davidmc5/Wifi_Node_PCB/BOM - WIFI RELAY NODE.xlsx

Qty | Value | Device | Package | Parts | Description | DIGI-KEY_PART_NUMBER | DIGI-KEY_PURCHASE_URL | MF | MPN | PRICE | Extended price | Comments
0 | 20V 0.5A | Diode MBR0520 | SOD123 | D1, D2 | Diode Schottky 20V 500mA | MBR0520LT3GOSCT-ND | https://www.digikey.com/product-detail/en/on-semiconductor/MBR0520LT3G/MBR0520LT3GOSCT-ND/2705022 | ON Semiconductor | MBR0520LT3G | $0.34 | $0.00
2 | 20V 0.5A | Diode MBR0520 | SOD123 | D1, D2 | Diode Schottky 20V 500mA | MBR0520LT1GOSCT-ND | https://www.digikey.com/product-detail/en/on-semiconductor/MBR0520LT3G/MBR0520LT3GOSCT-ND/2705022 | ON Semiconductor | MBR0520LT3G | $0.04 | $0.08 | For JLCPCB - Digikey had 0 stock
5 | 0.1uF | 0.1UF 25V-20% | 0603 | C5, C6, C7, C8, C9 | 0.1µF ceramic capacitors | 399-1100-1-ND | https://www.digikey.com/product-detail/en/kemet/C0603C104Z3VACTU/399-1100-1-ND/411375 | KEMET | C0603C104Z3VACTU | $0.10 | $0.50
4 | 10uF | 10UF-25V-20% | 0805 | C1, C2, C3, C4 | 10.0µF ceramic capacitors | 490-10503-1-ND | https://www.digikey.com/product-detail/en/murata-electronics/GRM21BC81E106ME51L/490-10503-1-ND/5026431 | Murata Electronics | GRM21BC81E106ME51L | $0.37 | $1.48
4 | 10k | 10KOHM-0603-1/10W-5% | 0603 | R1, R2, R3, R4 | 10k resistor | 311-10KGRCT-ND | https://www.digikey.com/product-detail/en/yageo/RC0603JR-0710KL/311-10KGRCT-ND/729647 | Yageo | RC0603JR-0710KL | $0.10 | $0.40
3 | 1k | 1KOHM-0603-1/10W-5% | 603 | R5, R6, R7 | 1k resistor | 311-1.0KGRCT-ND | https://www.digikey.com/product-detail/en/yageo/RC0603JR-071KL/311-1-0KGRCT-ND/729624 | Yageo | RC0603JR-071KL | $0.10 | $0.30
0 | 8-pin male header | CONN_1X08 | 1x08 | J4 | Header-pin |  |  |  |  |  | $0.00
1 | ESP-WROOM-02U | ESP-WROOM-02U | 18-SMD Module | U1 | WiFi module | 1904-1022-1-ND | https://www.digikey.com/product-detail/en/espressif-systems/ESP-WROOM-02U/1904-1022-1-ND/9381731 | Espressif Systems | ESP-WROOM-02U | $3.20 | $3.20
1 | 2-Pin male header | CONN_1X02 | 1X02 (Pitch 2.54mm) | J2 | 2-Pin male header | 952-2262-ND | https://www.digikey.com/product-detail/en/harwin-inc/M20-9990246/952-2262-ND/3728226 | Harwin | M20-9990246 | $0.11 | $0.11
1 | 6-Pin male header | CONN_1X06 | 1X06 (Pitch 2.54mm) | J3 | 6-Pin male header | 609-3263-ND | https://www.digikey.com/product-detail/en/amphenol-icc-fci/68000-406HLF/609-3263-ND/1878471 | Amphenol | 68000-406HLF | $0.27 | $0.27
1 | 20-pin Female header | CONN_2X10 | 2X10 (Pitch 2.54mm) | J1 | 20-pin Female header | S7078-ND | https://www.digikey.com/product-detail/en/sullins-connector-solutions/PPTC102LFBN-RC/S7078-ND/810216 | Sullins | PPTC102LFBN-RC | $1.30 | $1.30
 |  |  |  |  |  |  |  |  |  |  | $0.00
0 | TLV75533 | Voltage regulator 3.3 V - 500 mA | SOT-23-5 | U3 | Linear Voltage Regulator | 296-50411-1-ND | https://www.digikey.com/product-detail/en/texas-instruments/TLV75533PDBVR/296-50411-1-ND/9685550 | Texas Instruments | TLV75533PDBVR | $0.39 | $0.00
1 | MIC5504-3.3 | Voltage regulator 3.3 V - 300 mA | SOT-23-5 | U3 | Linear Voltage Regulator | 576-4764-1-ND | https://www.digikey.com/product-detail/en/microchip-technology/MIC5504-3-3YM5-TR/576-4764-1-ND/4864028 | Microchip Technology | MIC5504-3.3YM5-TR | $0.11 | $0.11 | For JLCPCB
 |  |  |  |  |  |  |  |  |  |  | $0.00
0 | MCP23018 | I/O expander 16bit | 24-SSOP | U2 | I/O expander 16bit | MCP23018-E/SS-ND | https://www.digikey.com/product-detail/en/microchip-technology/MCP23018-E-SS/MCP23018-E-SS-ND/1999506 | Microchip Technology | MCP23018-E/SS | $1.66 | $0.00
1 | MCP23018 | I/O expander 16bit | 28-SOIC | U2 | I/O expander 16bit | MCP23018-E/SO-ND | https://www.digikey.com/product-detail/en/microchip-technology/MCP23018-E-SO/MCP23018-E-SO-ND/1999504 | Microchip Technology | MCP23018-E/SO | $1.51 | $1.51 | Larger pitch to make it easier to solder by hand
~~0~~ | ~~MCP23018~~ | ~~MCP23018T-E/SO~~ | ~~28-SOIC~~ | ~~U2~~ | ~~I/O expander 16bit~~ | ~~MCP23018T-E/SOCT-ND~~ | ~~https://www.digikey.com/product-detail/en/microchip-technology/MCP23018T-E-SO/MCP23018T-E-SOCT-ND/9643016~~ | ~~Microchip Technology~~ | ~~MCP23018T-E/SO~~ | ~~$1.51~~ | $0.00
~~0~~ | ~~MCP23017~~ | ~~MCP23017~~ | ~~28-SOIC~~ | ~~U2~~ | ~~16 IO expander~~ | ~~ MCP23017T-E/SOCT-ND~~ | ~~https://www.digikey.com/product-detail/en/microchip-technology/MCP23017T-E-SO/MCP23017T-E-SOCT-ND/5358289~~ | ~~MICROCHIP~~ | ~~MCP23017T-E/SO~~ | ~~$1.20~~ | $0.00
