davidmc5/Wifi_Node_PCB/relay node.brd

## EAGLE design relay node.brd (2020-06-28)

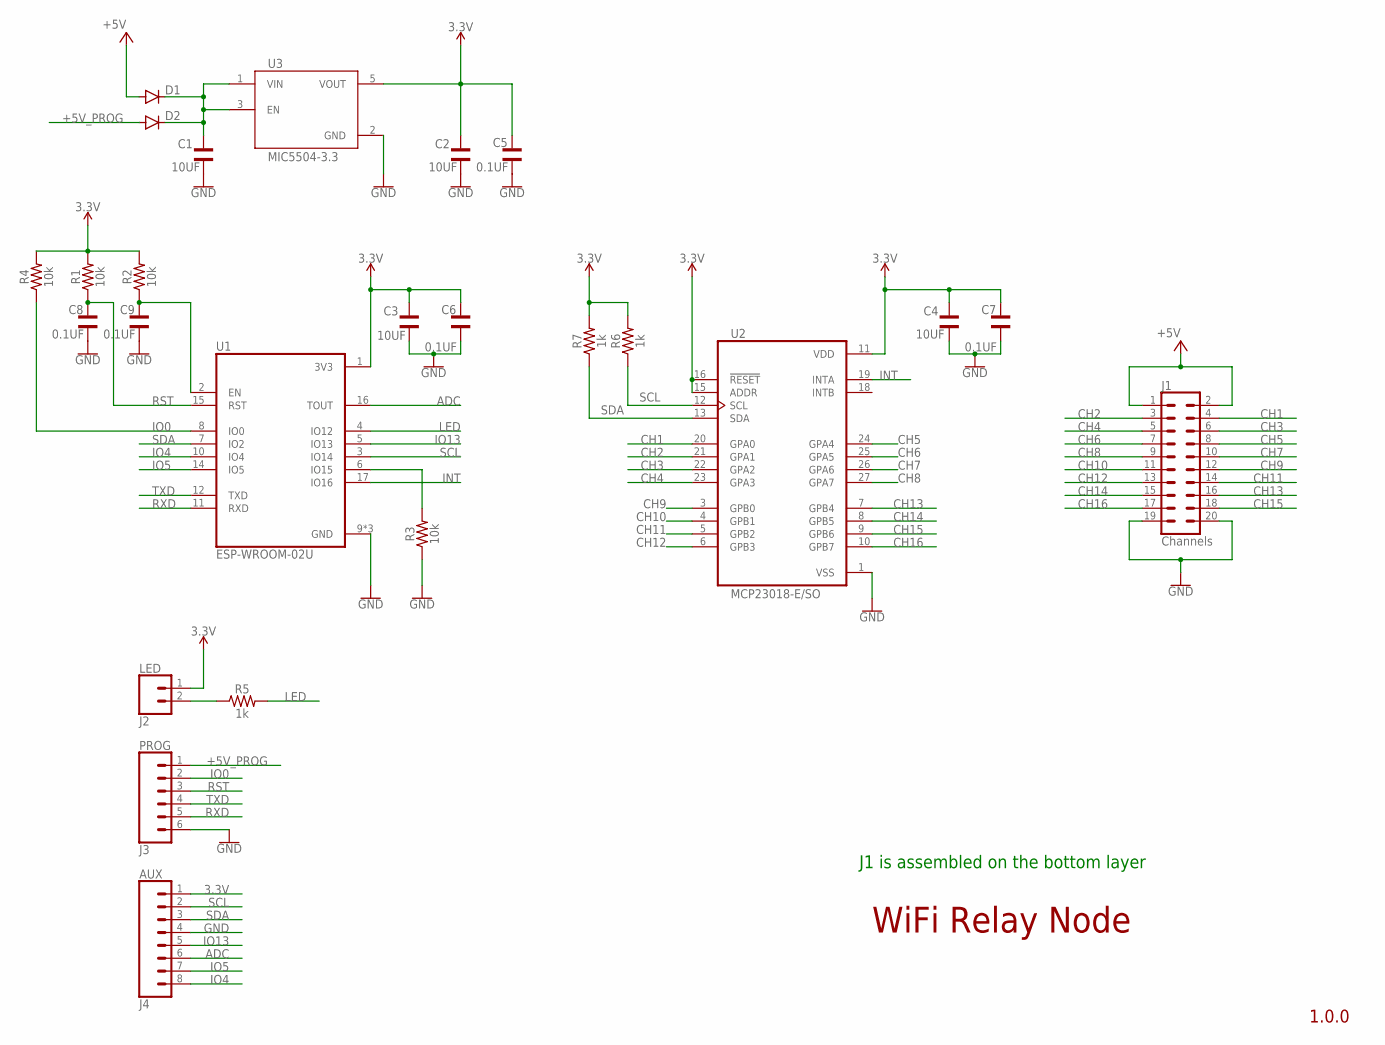
[picture p1: schematic relay node.sch]

Parts:
C1, C2, C3, C4: 10UF; CAPC2012X135N
C5, C6, C7, C8, C9: 0.1UF; CAPC1608X90
D1, D2: MBR0520LT; SOD123
J1: Channels; 2X10_NOSILK
J2: LED; 1X02
J3: PROG; 1X06
J4: AUX; 1X08
R1, R2, R3, R4: 10k; 0603
R5, R6, R7: 1k; 0603
U1: ESP-WROOM-02U; MODULE_ESP-WROOM-02U
U2: MCP23018-E/SO; SOIC127P1030X265-28N
U3: MIC5504-3.3; SOT95P280X145-5N

Connections:
3.3V: C2.1, C3.1, C4.1, C5.1, C6.1, C7.1, J2.1, J4.1, R1.2, R2.2, R4.2, R6.2, R7.2, U1.1 (3V3), U2.11 (VDD), U2.15 (ADDR), U2.16 (!RESET), U3.5 (VOUT)
+5V: D1.A, J1.1, J1.2
+5V_PROG: D2.A, J3.1
ADC: J4.6, U1.16 (TOUT)
CH1: J1.4, U2.20 (GPA0)
CH2: J1.3, U2.21 (GPA1)
CH3: J1.6, U2.22 (GPA2)
CH4: J1.5, U2.23 (GPA3)
CH5: J1.8, U2.24 (GPA4)
CH6: J1.7, U2.25 (GPA5)
CH7: J1.10, U2.26 (GPA6)
CH8: J1.9, U2.27 (GPA7)
CH9: J1.12, U2.3 (GPB0)
CH10: J1.11, U2.4 (GPB1)
CH11: J1.14, U2.5 (GPB2)
CH12: J1.13, U2.6 (GPB3)
CH13: J1.16, U2.7 (GPB4)
CH14: J1.15, U2.8 (GPB5)
CH15: J1.18, U2.9 (GPB6)
CH16: J1.17, U2.10 (GPB7)
GND: C1.2, C2.2, C3.2, C4.2, C5.2, C6.2, C7.2, C8.2, C9.2, J1.19, J1.20, J3.6, J4.4, R3.1, U1.9 (GND), U1.13 (GND), U1.18 (GND), U2.1 (VSS), U3.2 (GND)
INT: U1.17 (IO16), U2.19 (INTA)
IO0: J3.2, R4.1, U1.8 (IO0)
IO4: J4.8, U1.10 (IO4)
IO5: J4.7, U1.14 (IO5)
IO13: J4.5, U1.5 (IO13)
LED: R5.2, U1.4 (IO12)
unnamed: C1.1, D1.C, D2.C, U3.1 (VIN), U3.3 (EN)
unnamed: R3.2, U1.6 (IO15)
unnamed: C9.1, R2.1, U1.2 (EN)
unnamed: J2.2, R5.1
RST: C8.1, J3.3, R1.1, U1.15 (RST)
RXD: J3.5, U1.11 (RXD)
SCL: J4.2, R6.1, U1.3 (IO14), U2.12 (SCL)
SDA: J4.3, R7.1, U1.7 (IO2), U2.13 (SDA)
TXD: J3.4, U1.12 (TXD)

Notes on the sheet:
1.0.0
WiFi Relay Node
J1 is assembled on the bottom layer

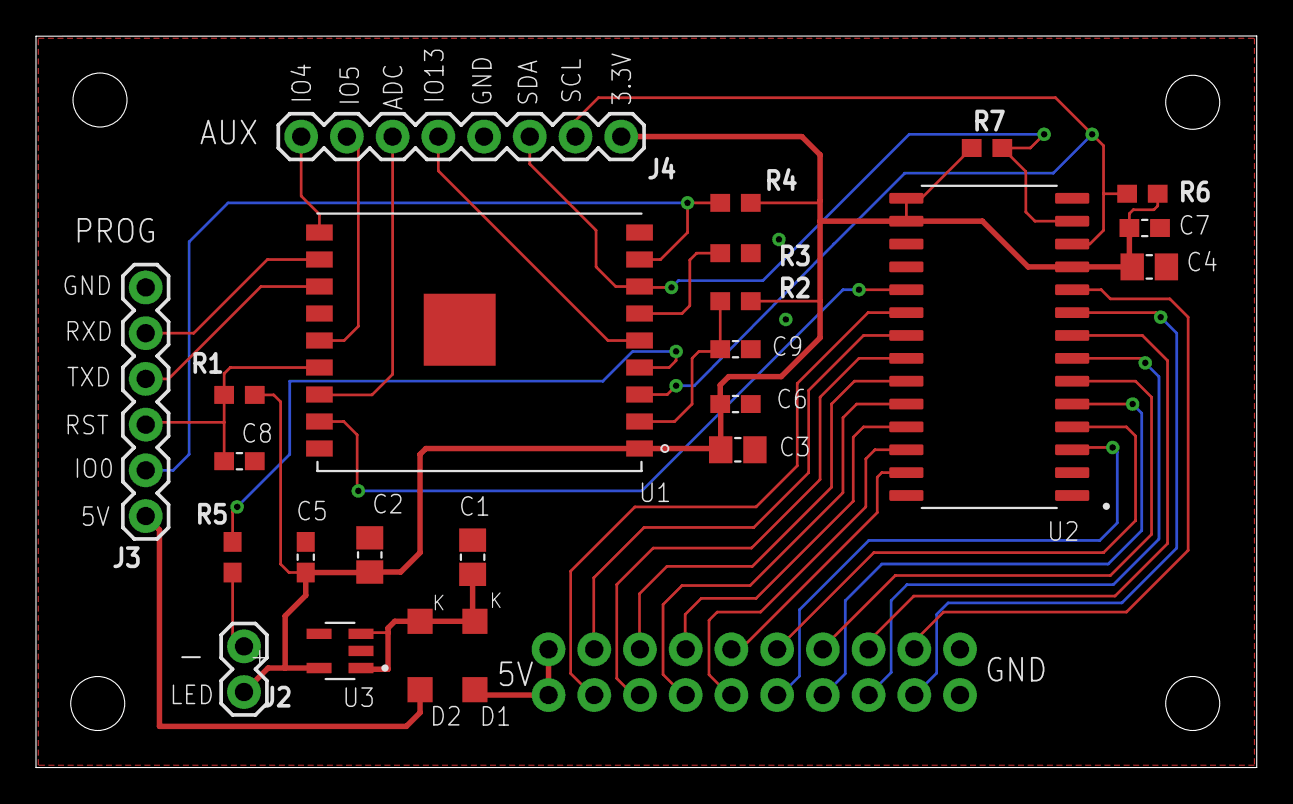
[picture p2: board relay node.brd from above]

Board: 2 copper layers, 67.8 x 40.6 mm, 25 parts (1 on the bottom side), 36 nets.
