davidmc5/Wifi_Node_PCB/(commit log)

2020-06-16 Initial commit Using MCP23017 and 2 x ULN2803 NPN arrays
    [ESP-wroom-02U.brd, ESP-wroom-02U.sch]
2020-06-16 Edited wifi IC footprint - Removed solder mask and solder paste (tcream layer) from esp-wroom IC -Updated BOM
    [BOM - WIFI RELAY NODE.xlsx, ESP-wroom-02U.brd, relay node.brd, relay node.sch]
2020-06-16 Minor changes
    [BOM - WIFI RELAY NODE.xlsx, BOM-assembly.xlsx, relay node.brd, relay node.sch]
2020-06-20 Move J1 to bottom layer Add J1 to J3 connectors to BOM for quotes
    [BOM - WIFI RELAY NODE.xlsx, BOM-assembly.xlsx, relay node.brd, relay node.sch]
2020-06-27 Replace I/O expander to MCP23018 28-SOIC Replace BOM part numbers to match JLCPB inventory
    [BOM - WIFI RELAY NODE.xlsx, BOM-assembly.xlsx, relay node.brd, relay node.sch]
2020-06-28 Replace volt regulator
    [BOM-assembly.xlsx, relay node.brd, relay node.sch]
2020-06-28 Minor changes for production PCB ordered - v1.0.0
    [BOM - WIFI RELAY NODE.xlsx, BOM-assembly.xlsx, relay node.brd, relay node.sch]
